HarryJain/cpsc-334-module6/README.md

# cpsc-334-module6
The code implementing S.C.O.T.'s AI takeover of AKW.
