HarryJain/cpsc-334-module6/mesh_networking/assets/all_closed.JPG

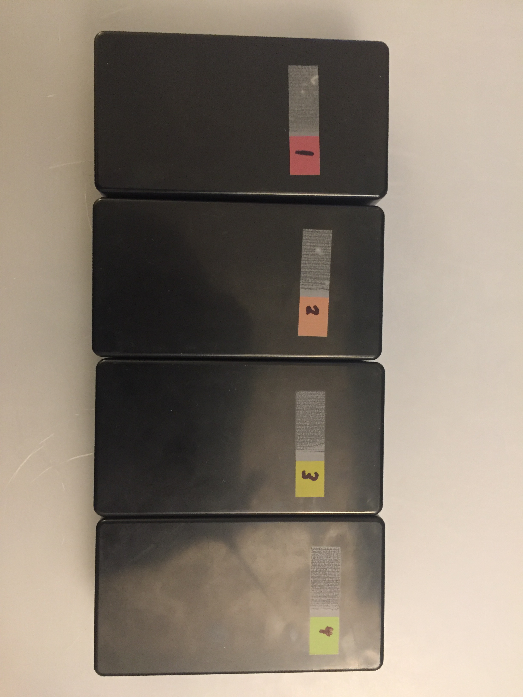
mesh_networking/assets/all_closed.JPG
