HarryJain/cpsc-334-module6/mesh_networking/assets/angled_remotes.JPG

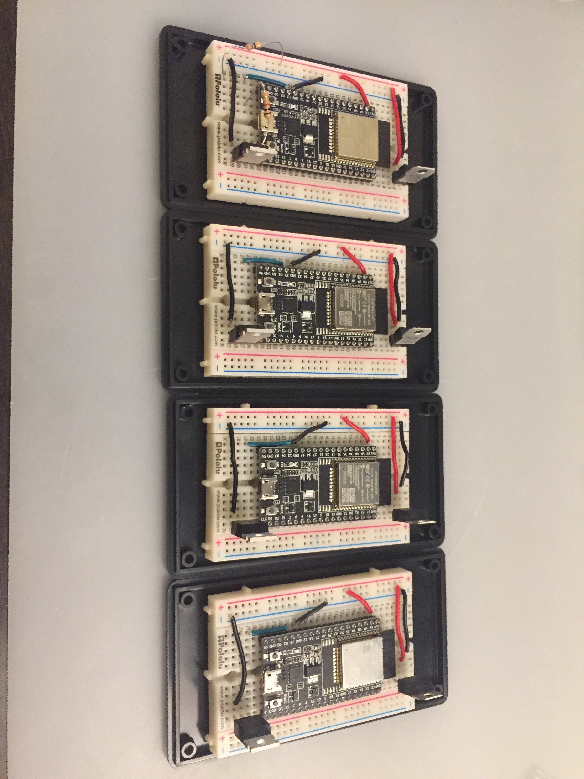
mesh_networking/assets/angled_remotes.JPG
