HarryJain/cpsc-334-module6/mesh_networking/assets/black_speakers.png

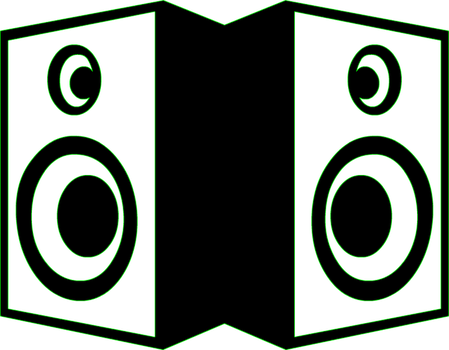
mesh_networking/assets/black_speakers.png
