HarryJain/cpsc-334-module6/mesh_networking/assets/bluetooth_speaker.png

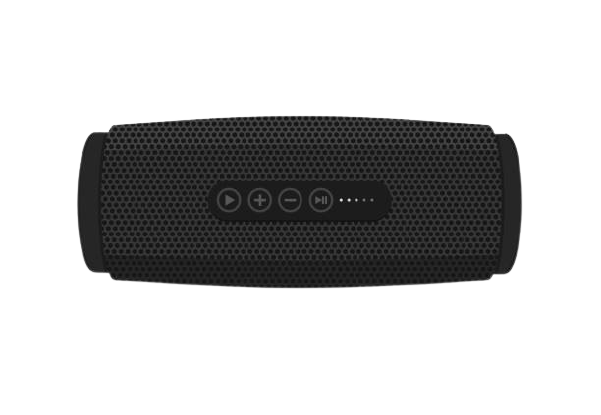
mesh_networking/assets/bluetooth_speaker.png
