HarryJain/cpsc-334-module6/mesh_networking/assets/charging_brigade.JPG

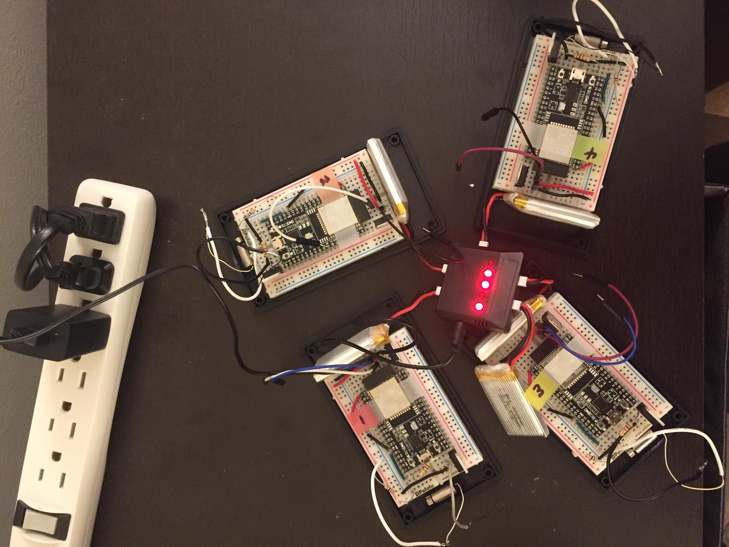
mesh_networking/assets/charging_brigade.JPG
