HarryJain/cpsc-334-module6/mesh_networking/assets/color_robot_head.png

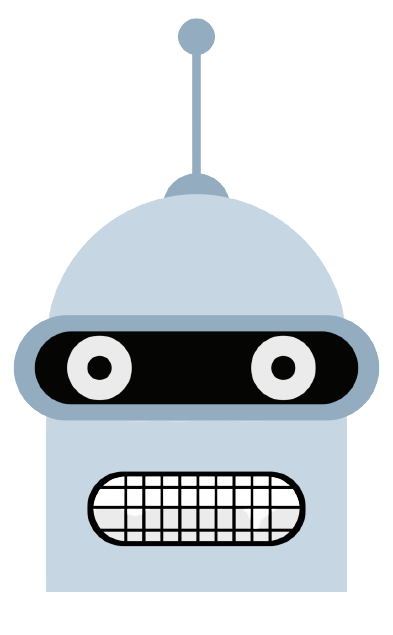
mesh_networking/assets/color_robot_head.png
