HarryJain/cpsc-334-module6/mesh_networking/assets/exposed_circuit.JPG

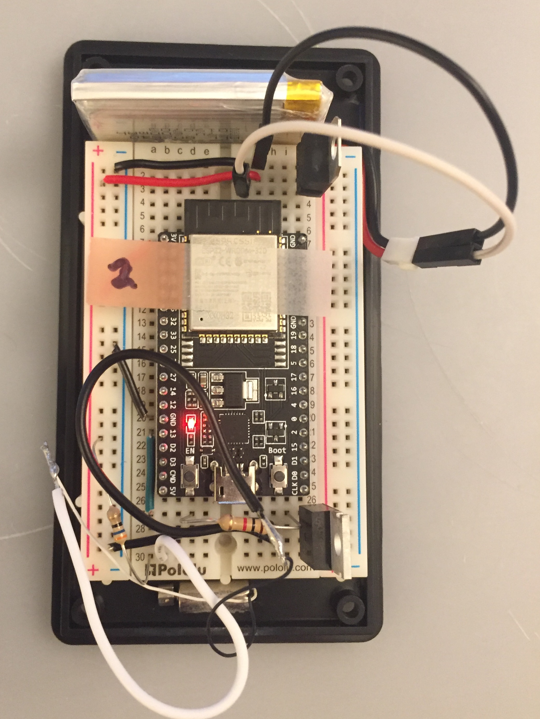
mesh_networking/assets/exposed_circuit.JPG
