HarryJain/cpsc-334-module6/mesh_networking/assets/initial_buzzer_circuit.JPG

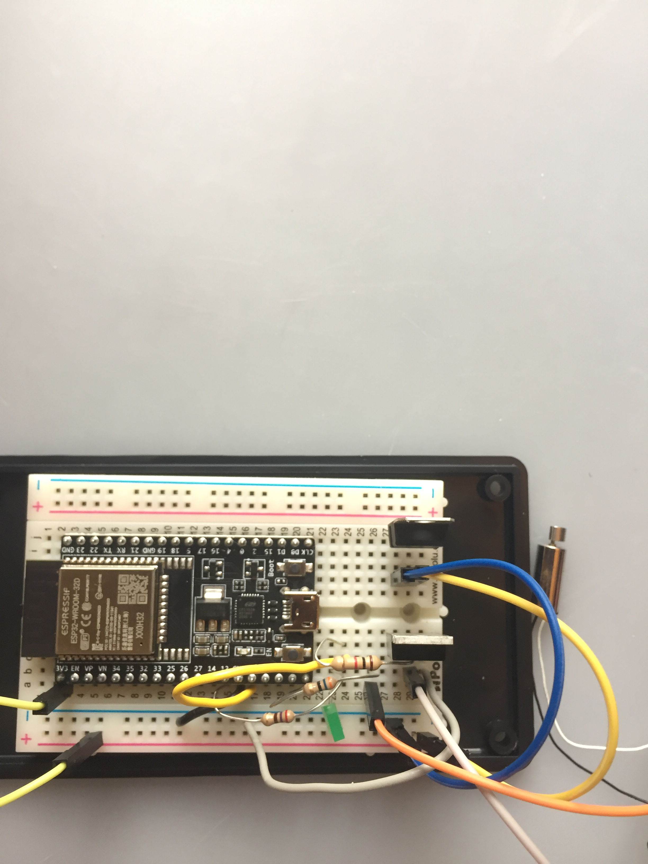
mesh_networking/assets/initial_buzzer_circuit.JPG
