HarryJain/cpsc-334-module6/mesh_networking/assets/macbook.jpeg

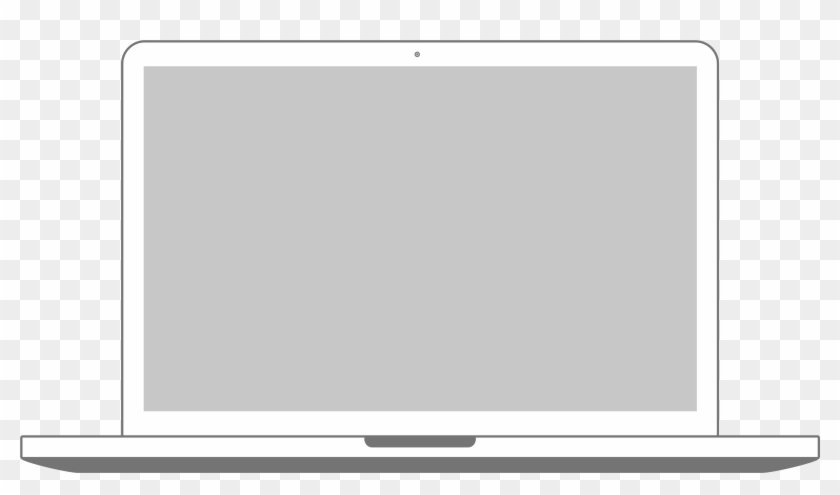
mesh_networking/assets/macbook.jpeg
