HarryJain/cpsc-334-module6/mesh_networking/assets/part_aggregation.JPG

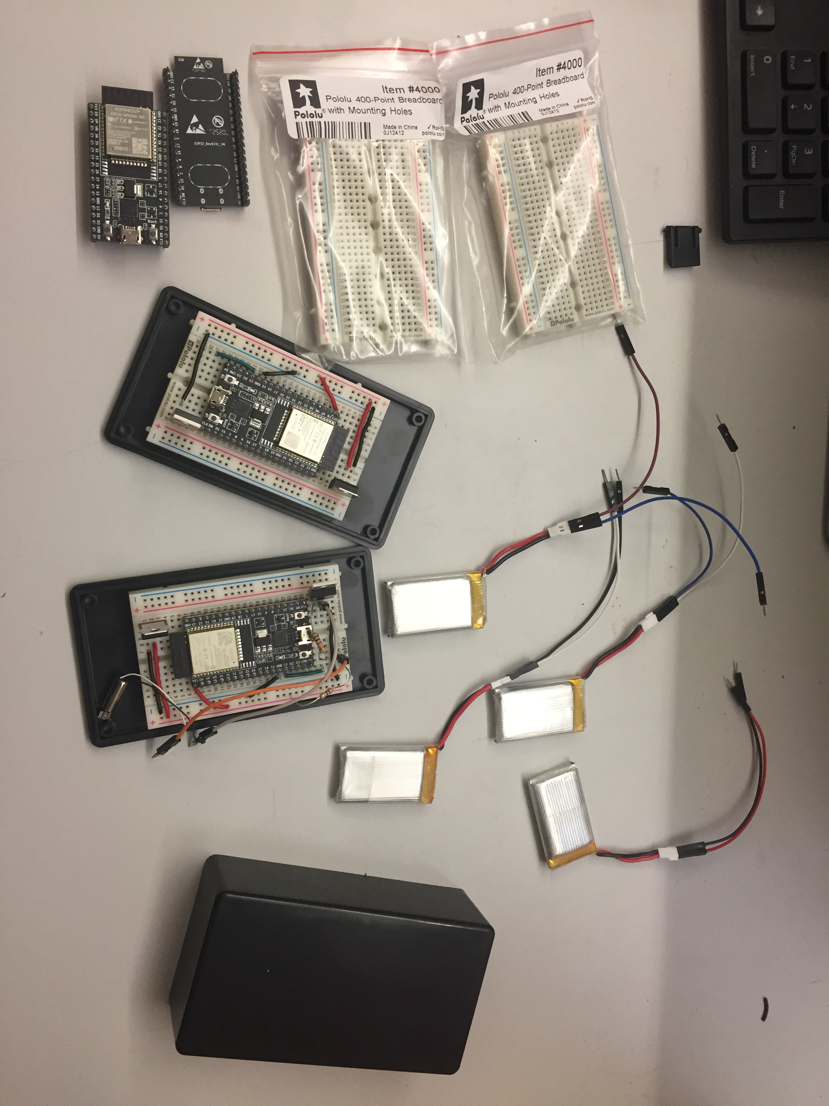
mesh_networking/assets/part_aggregation.JPG
