HarryJain/cpsc-334-module6/mesh_networking/assets/remote_circuits.JPG

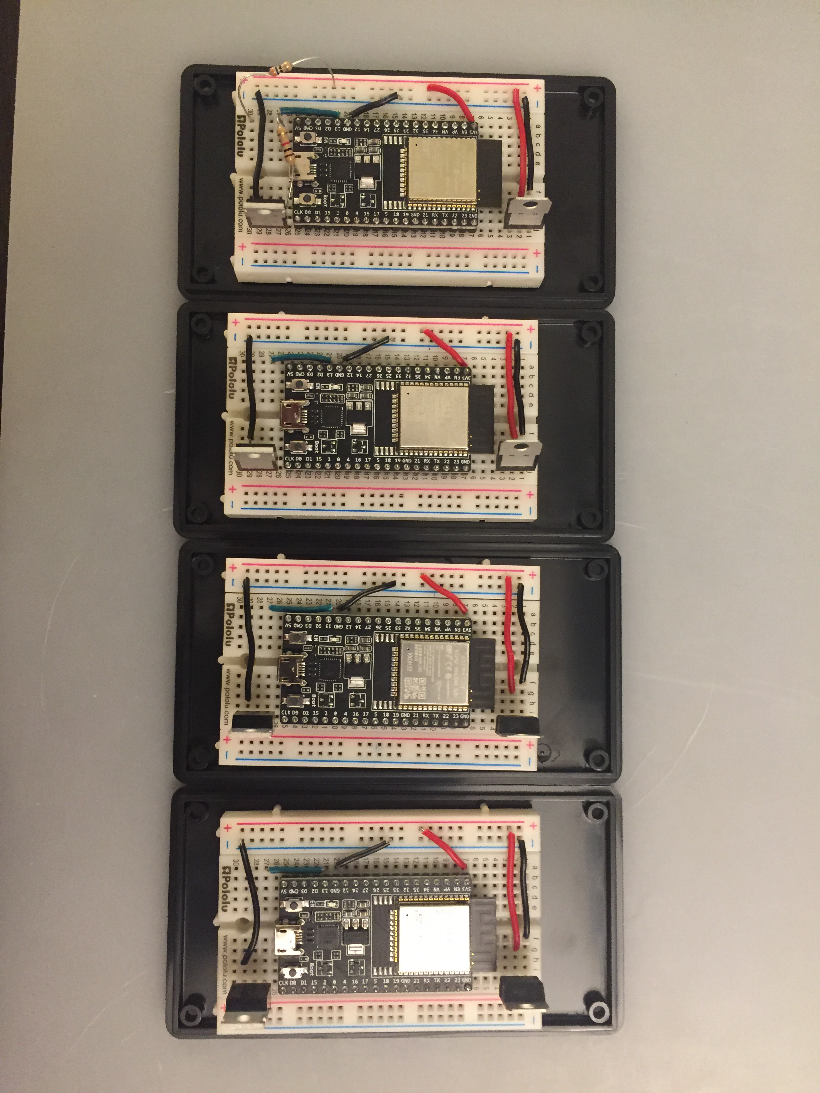
mesh_networking/assets/remote_circuits.JPG
