HarryJain/cpsc-334-module6/mesh_networking/assets/robot_edited.png

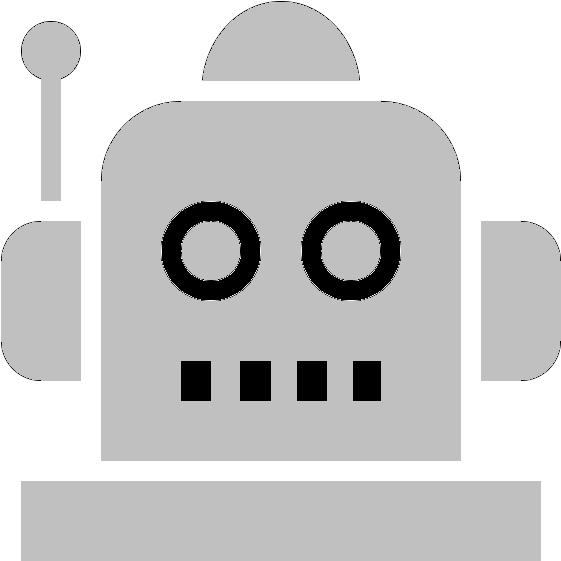
mesh_networking/assets/robot_edited.png
