HarryJain/cpsc-334-module6/projections/copy_humans/akw1.jpg

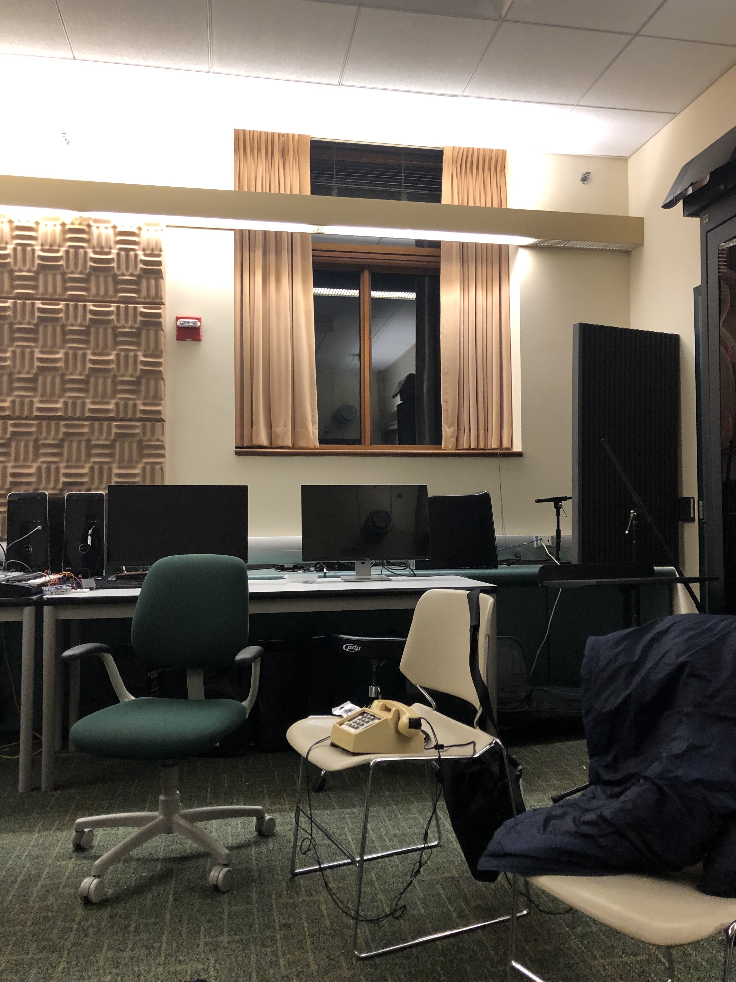
projections/copy_humans/akw1.jpg
