HarryJain/cpsc-334-module6/mesh_networking/assets/buzzer_solder.JPG

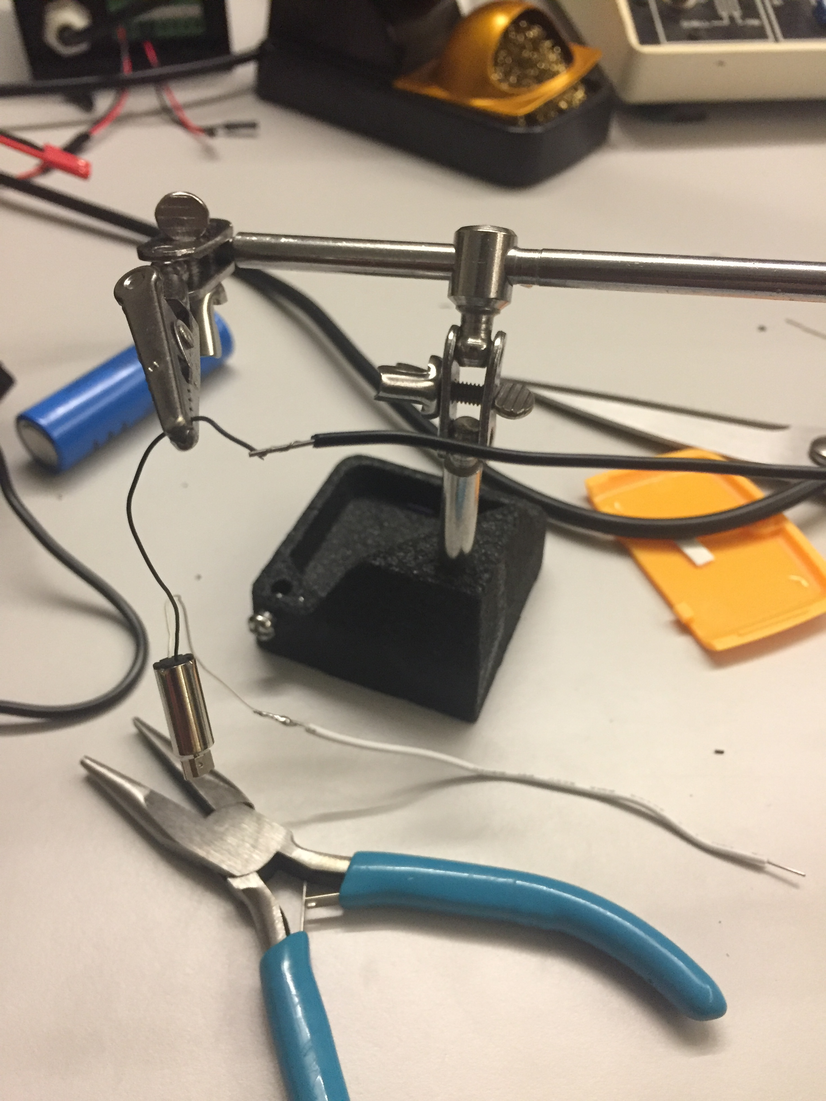
mesh_networking/assets/buzzer_solder.JPG
