HarryJain/cpsc-334-module6/(list of files, drawings)

Other design files:
mesh_networking/spectre_remote.fzz
