HarryJain/cpsc-334-module6/audio/playsound_basement.py

# A simple sound player
# Plays a loop until it receives a trigger from an ESP32, then plays another sound, then switches back to the loop

import pygame
import time
import serial

# Starting the mixer
pygame.mixer.pre_init(44100, -16, 2, 1024)
pygame.init()
pygame.mixer.quit()
pygame.mixer.init(44100, -16, 2, 1024)

pygame.init()

# play a sound on channel 0
pygame.mixer.Channel(0).play(
    pygame.mixer.Sound('sounds/melody-loop-2-stan.wav'), -1)

trigger = 'FALSE'

# Set up serial reading
ser = serial.Serial()
ser.port = '/dev/cu.usbserial-110'
ser.open()

while True:
    # Parse each input string into array of individual values
    line = ser.readline()
    print(line)
    if line != b'FALSE\r\n' and line != b'TRUE\r\n':
        continue
    decoded_line = line[0:len(line)-2].decode("utf-8")
    split_line = decoded_line.split(',')
    new_trigger = split_line[0]
    print(new_trigger)

    if trigger == 'FALSE' and new_trigger == 'TRUE':
        trigger = 'TRUE'
        pygame.mixer.Channel(0).play(
            pygame.mixer.Sound('sounds/stan-voice-1.wav'), -1)
        time.sleep(112)
        ser.reset_input_buffer()
        pygame.mixer.Channel(0).play(
            pygame.mixer.Sound('sounds/melody-loop-2-stan.wav'), -1)
    trigger = new_trigger
