HarryJain/cpsc-334-module6/projections/copy_humans/copy_humans.pde

import processing.video.*;


Circle c1;
Circle c2;
Circle c3;

//int nFaces;

int radius = 500;

Capture cam;

void setup()
{

  fullScreen();
  width = displayWidth;
  height = displayHeight;
  c1 = new Circle(color(255,0,0),(int)random(100, (int)(displayWidth * 0.75)), (int)random(100, (int)(displayHeight * 0.75)), (int)random(500,1000), 100.);
  c2 = new Circle(color(0,0,255), (int)random(100, (int)(displayWidth * 0.75)), (int)random(100, (int)(displayHeight * 0.75)), (int)random(500,1000), 200.);
  c3 = new Circle(color(0,255,0), (int)random(100, (int)(displayWidth * 0.75)), (int)random(100, (int)(displayHeight * 0.75)), (int)random(500,1000), 300.);
  
  background(0);
  String[] dims = loadStrings("../dims");
  String[] splitDims = dims[0].split(",");
  cam = new Capture(this, parseInt(splitDims[1]), parseInt(splitDims[0]), 30);
  cam.start();
  
  
}

void draw()
{
   if(cam.available()) {
    cam.read();
  }
  cam.filter(GRAY);

  blendMode(ADD);
  c1.shift();
  c1.display();
  c2.shift();
  c2.display();
  c3.shift();
  c3.display();
    filter(BLUR, 20);
    
   
    
  blendMode(SUBTRACT);
  PImage img = loadImage("akw1.jpg");
  img.resize(width, height);
  image(img, 0, 0);
  ////fill(255);
  ////textSize(18);
  ////text("there is no solution", (int)random(100, (int)(displayWidth * 0.75)), (int)random(100, (int)(displayHeight * 0.75))); 

  String[] faceCoords = loadStrings("../faceread");
  //println(faceCoords[0]);

  if(faceCoords.length >= 1 && faceCoords[0] != "")
  {
    //split string into groups of 4
    String[] splitFaceCoords = faceCoords[0].split(",");
    int[] faces = new int[splitFaceCoords.length];
    for(int i = 0; i < splitFaceCoords.length; i++)
    {
       faces[i] = parseInt(splitFaceCoords[i]);
       //println(intFaceCoords[i]);
    }
    int nFaces = faces[0];
  
    blendMode(ADD);
    for(int j = 1; j < (4 * nFaces) + 1; j+= 4)
    {
        //noFill();
        //strokeWeight(12);
        //stroke(255,0,0);
        //10+vol*200, 10+vol*200
        //rect(offsetX + faces[j], offsetY + faces[j+1], faces[j+2], faces[j+3]);
        println(faces[j], faces[j+1], faces[j+2], faces[j+3]);
        PImage human = cam.get(faces[j], faces[j+1], faces[j+2], faces[j+3]);
        //image(human, 0,0);
        image(human, (int)random(0, displayWidth - faces[j+2]), (int)random(0, displayWidth - faces[j+3]));
    }

}
}

class Circle {
  color c;
  float xpos;
  float ypos;
  int rad;
  float speed;
  int xdirection = 1;  // Left or Right
  int ydirection = 1;  // Top to Bottom

  // The Constructor is defined with arguments.
  Circle(color tempC, float tempXpos, float tempYpos, int tempXradius, float tempSpeed) {
    c = tempC;
    xpos = tempXpos;
    ypos = tempYpos;
    rad = tempXradius;
    speed = tempSpeed;
  }

  void display() {
    noStroke();
    fill(c);
    //rectMode(CENTER);
    //rect(xpos,ypos,20,10);
    circle(xpos, ypos, rad);
  }

  void shift() {
    xpos = (int)random(0, displayWidth);
    ypos = (int)random(0, displayHeight);
    //xpos = xpos + speed * xdirection;
    //ypos = ypos + speed * ydirection;
  //  if (xpos >= width-rad || xpos <= rad) {
  //  xdirection *= (-1 * random(0.5,1));
  //  }
  //  if (ypos >= height-rad || ypos <= rad) {
  //    ydirection *= (-1 * random(0.5,1));
  //  }
  }
}
