HarryJain/cpsc-334-module6/(commit log)

2021-12-04 Fixed remote and installation code, made Fritzing diagram for remotes, reorganized folders
    [spectre_remote.fzz]
2021-12-05 Fixed enclosure image
2021-12-05 Finally fixed enclosure image for real
